ZeroNolidge/RoryRobot32/body/stl/rory_body.stl

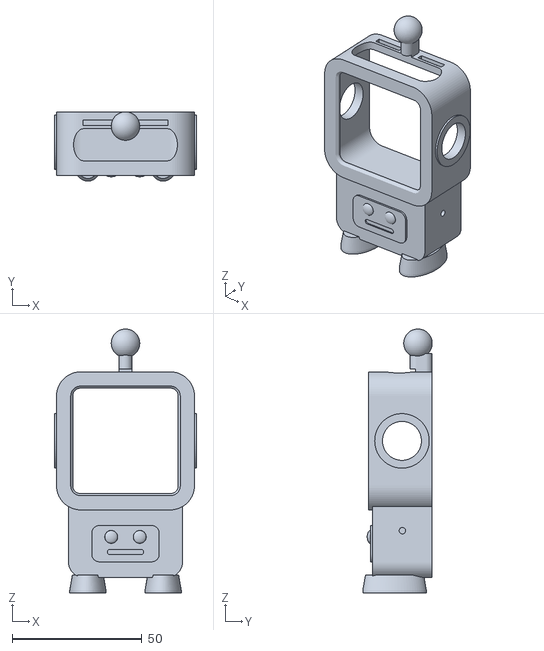
[picture p5: CAD file, 2026-11-13]
body/stl/rory_body.stl
54.8 x 26.8 x 101.7
