ZeroNolidge/RoryRobot32/body/stl/rory_cover.stl

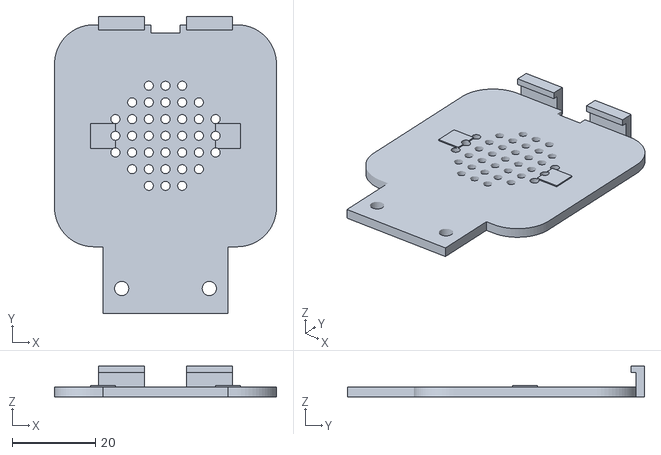
[picture p6: CAD file, 2026-11-13]
body/stl/rory_cover.stl
53.2 x 71.2 x 7.40
