ZeroNolidge/RoryRobot32/body/stl/rory_arm.stl

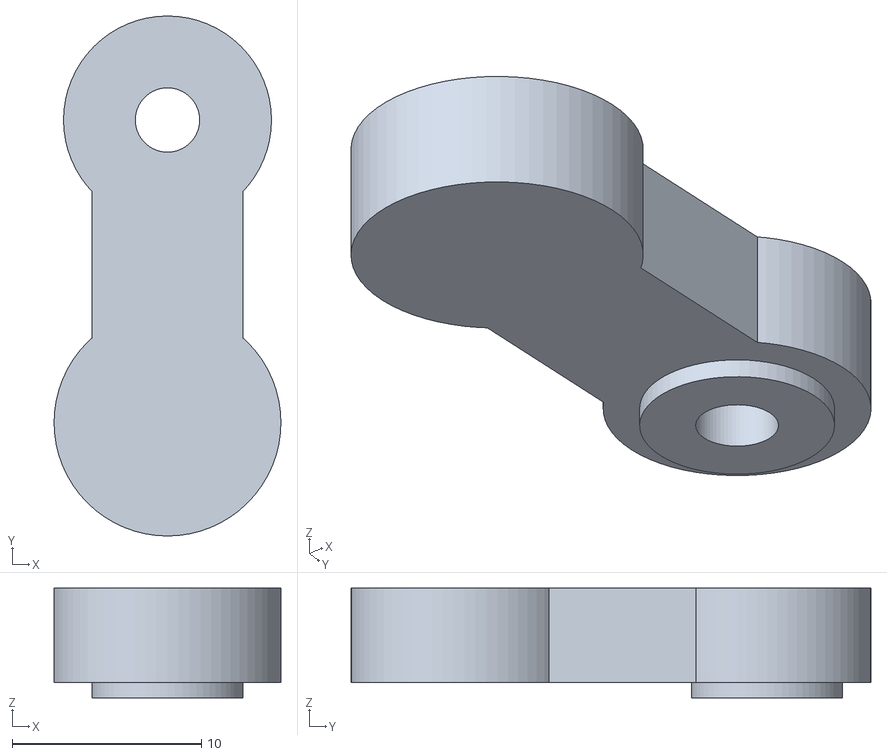
[picture p7: CAD file, 2026-11-13]
body/stl/rory_arm.stl
12.0 x 27.5 x 5.80
