ZeroNolidge/RoryRobot32/firmware/src/settings.h

// Rory's settings, read from the microSD card so nothing secret is in the code.
//
//   /rory/config.txt
//     wifi_name     = MyHomeWiFi
//     wifi_password = secret
//     server        = https://rory-server.yourname.workers.dev
//     token         = the RORY_DEVICE_TOKEN you set on the server
#pragma once
#include <Arduino.h>

namespace Settings {
struct Values {
  String wifiName, wifiPassword, server, token;
};
bool load();          // call after the SD card is mounted
const Values& get();
bool aiConfigured();  // Wi-Fi + server + token all present
}  // namespace Settings
