ZeroNolidge/RoryRobot32/(commit log)

2026-11-12 Rory the Robot: phase 1 firmware for Waveshare ESP32-S3-Touch-LCD-1.54
    Animated face in Rory's app colors (blinks, glances, lip sync, happy/dizzy/
    sleepy/love expressions), touch gestures (boop, tickle, hold-to-talk,
    eye-follow), motion reactions (pickup, shake, tilt, face-down), sleep/wake
    and power-off, and voice clips from the Talk Trail app played from microSD.
    Includes an SD card builder for the app's clips and a PC face previewer.
    Claude-Session: https://claude.ai/code/session_011oQsxjUykdYPaxr6bkogkh
2026-11-13 Add high five, dance, walk, hug and tuck-in reactions
    All from the motion sensor, no extra parts: a single tap on her body is a
    high five, a steady bounce is dancing (eyes swing, face hops), small steady
    hops are walking, being held quietly gives heart eyes, and lying on her back
    tucks her in to sleep. Pick-ups now need a real tilt or turn, so a tap while
    she sits on the table doesn't count as being lifted. MOTION_DEBUG prints the
    sensor values for tuning. Adds highfive/dance/walk voice folders.
    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
    [brain.cpp, brain.h, config.h, face.cpp, face.h, senses.cpp, senses.h]
2026-11-13 Add a 3D-printable Rory body for the Waveshare case
    OpenSCAD design (~10 cm tall): the board's own 46 x 46 x 22.5 mm case slides
    into the head from the back, the screen is her face, and a hooked back cover
    with a speaker grille screws on. Includes swivel arms on M3 shoulder screws,
    feet, antenna, chest panel, side windows for the microSD slot, a top window
    for the buttons and a USB-C tunnel between the feet. STLs, previews and a
    print/paint/assembly guide included; hole positions are parameters to check
    against the real board.
    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
    [rory_arm.stl, rory_body.scad, rory_body.stl, rory_cover.stl]
2026-11-13 Let Rory ask her AI server: Wi-Fi, recording and streamed answers
    Holding a finger on her face now records his question from the ES7210 dual
    mics (16 kHz WAV, up to 12 s; the speaker player steps aside while she
    listens), sends it to the server over verified HTTPS, shows a thinking face,
    then streams her answer in her voice with the face the answer asks for.
    Follow-ups keep 3 minutes of history. Wi-Fi and server details come from
    /rory/config.txt on the SD card (make_sdcard.py can write it). Offline or on
    errors she plays a clip instead.
    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
    [brain.cpp, brain.h, main.cpp, net.cpp, net.h, settings.cpp]
2026-11-14 Fix screen-up direction for the real board; add a start-up check line
    Measured on the user's board: the IMU's z axis reads -1 g with the screen
    facing up, so tuck-in (lying on her back) never fired. Also wait briefly for
    the Serial Monitor at boot and print a one-line hardware check.
    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
    [config.h, main.cpp]
2026-11-14 Make taps, bounces and hugs detectable
    The accelerometer's strongest built-in low-pass filter (~3 Hz at 125 Hz ODR)
    was smoothing away taps and bounces, and the sensor was only read between
    animation frames. Now: 250 Hz with a light filter, read in its own task at
    ~250 Hz, events go through a thread-safe queue. 'Resting' uses a tighter gyro
    threshold (this board reads ~1.4 deg/s when still), so being held gently no
    longer counts as sitting on the table and hugs can fire. MOTION_DEBUG now
    prints the peak values per 0.1 s and every detected event.
    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
    [senses.cpp]
